nioom/laser/dokumentacja.xlsx

Sheet: Wartości
 | <- można zmieniać
Nazwa | Wartość | [ ] | Pozostałe specyfikacje | Opis
fSW | 400 | kHz |  | częstotliwość przełączania
UIN | 12 | V |  | napięcie na wejściu
UOUT | 4.6 | V |  | napięcie na diodzie
ILED | 1.8 | A |  | prąd na diodzie
RLED | 0.4 | Ω |  | rezystancja dynamiczna diody, z wykresu
UREF | 0.2 | V |  | napięcie referencyjne
ILED(ripple)max | 0.02 | A |  | max. prąd tętnienia na diodzie
KIND | 0.2 |  |  | współczynnik tętnienia (limit 20% tętnienia)
UDIM | 2.2 | V |  | napięcie max. na pinie DIM
UPANGOLIN | 5 | V |  | napięcie od pangolina
C4 / CVCC | 1 | µF | 16V | stabilizacja regulatora
R4 / RFLT | 100 | Ω |  | rezystor filtrujący
C6 / CFLT | 1 | nF | 50V X7R ceramiczny | kondensator filtrujący
R3 / RCOMP | 100 | Ω |  | rezystor kompensacyjny
C5 / CCOMP | 1 | nF | 10V X7R ceramiczny | kondensator kompensacyjny
R6 / RLK_COMP | 22 | kΩ |  | kompensacja common-mode leakage
C1 / CIN | 47 | µF | 25V/50V elektrolityczny | główna pojemność*
C2 / CIN | 22 | µF | 25V/50V X7R ceramiczny | filtr tętnienia*
C3 / CVIN | 0.1 | µF | 25V/50V X7R ceramiczny | filtr hf*
C8 | 0.1 | µF | 25V/50V X7R ceramiczny | filtr hf na wyjściu
R7, R8, R9, R10 | 10 | kΩ |  | opamp
Z obliczeń (zmieniać na drugiej stronie):
R5 / RSENSE | 0.11 | Ω | 0,5 W | rezystor ograniczający prąd na diodzie
L | 22 | µH |  | indukcyjność cewki
C7 / CCOUT | 44 | µF | 25V/50V X7R ceramiczny | kondensator wyjściowy
R1 | 22 | kΩ |  | dzielnik napięcia na pinie DIM
R2 | 15 | kΩ

Sheet: Obliczenia
Nazwa | Wzór | Wynik | Wybrana wartość | [ ] | Opis
R5 / RSENSE | #VALUE! | 0.1111111111 | 0.11 | Ω | rezystor ograniczający prąd na diodzie
 |  | 0.3564 | 0.5 | W | moc na nim wydzielana
L | #VALUE! | 1.969907407e-05 | 22 | µH | indukcyjność cewki (IL(max) = ILED)
IL(ripple) | #VALUE! | 0.32 |  | A | tętnienie prądu na cewce, powinno być < 30%ILED = 0,54A
IL(peak) | #VALUE! | 1.96 |  | A | prąd nasycenia powinien być większy niż to
IL(rms) | #VALUE! | 1.80 |  | A | prąd znamionowy większy niż to
ZCOUT | #VALUE! | 0.0265 |  | Ω | minimalna impedancja na kondensatorze wyjściowym
C7 / CCOUT | #VALUE! | 1.503802348e-05 | 44 | µF | pojemność kondensatora wyjściowego x2
ZCOUT(real) | #VALUE! | 0.009 |  | Ω | rzeczywista impedancja
ILED(ripple) | #VALUE! | 0.007 |  | A | rzeczywiste tętnienie prądu LED (powinno być < 0,02A)
kPANGOLIN | #VALUE! | 0.44 |  |  | współczynnik do dzielnika napięcia na pinie DIM
R1 | proporcja | 56 | 22 | kΩ | dzielnik napięcia
R2 | proporcja | 44 | 15 | kΩ

Sheet: Dokumentacja
Nazwa | Link
TPS922051 | https://www.ti.com/lit/ds/symlink/tps922051.pdf?ts=1765485444840
Dioda NDG7475 | https://www.laserpointeur.com/c-40_104-p-10364.html
 | https://sites.google.com/site/dtrslasershop/dtrs-shop/diodes/ndg7475-1w-520nm

Sheet: BOM
opis | wartość | jednostka | ilość | ilość min | cena za sztukę | cena | link |  | uwagi
kondensator elektrolityczny | 47 | uF | 1 | 10 | 0.621 | 6.21 | TME (https://www.tme.eu/pl/details/sc1e476m6l005vr/kondensatory-elektrolityczne-smd/samwha/)
kondensator ceramiczny X7R 25V | 22 | uF | 5 | 10 | 0.918 | 9.18 | TME (https://www.tme.eu/pl/details/cl32b226kajnnne/kondensatory-mlcc-smd/samsung/)
kondensator ceramiczny | 100 | nF | 5 | 100 | 0.146 | 14.6 | mouser (https://www.mouser.pl/ProductDetail/TAIYO-YUDEN/MCASG168SB7104KTNA1J?qs=tlsG%2FOw5FFjWcbkHvwFonQ%3D%3D)
kondensator ceramiczny | 1 | uF | 1 | 10 | 0.288 | 2.88 | TME (https://www.tme.eu/pl/details/vj0603y105kxacw1bc/kondensatory-mlcc-smd/vishay/)
kondensator ceramiczny | 1 | nF | 2 | 10 | 0.142 | 1.42 | mouser (https://www.mouser.pl/ProductDetail/Vishay-Vitramon/VJ0603Y102KXBCW1BC?qs=o80U4RH5mTFKP2GWZao9Sg%3D%3D)
rezystor | 22 | kΩ | 2 | 50 | 0.0178 | 0.89 | TME (https://www.tme.eu/pl/details/wr06x223jtl/rezystory-smd/walsin/wr06x223-jtl/)
rezystor | 100 | Ω | 3 | 50 | 0.0229 | 1.145 | TME (https://www.tme.eu/pl/details/wr06x1000ftl/rezystory-smd/walsin/)
rezystor (0.5 W) pomiarowy | 0.11 | Ω | 1 | 5 | 1.18 | 5.9 | mouser (https://www.mouser.pl/ProductDetail/Susumu/RL1632R-R110-F?qs=tWzOfa%2FtRRwDOBij%2FFJT8g%3D%3D)
rezystor | 10 | kΩ | 4 | 100 | 0.0271 | 2.71 | TME (https://www.tme.eu/pl/details/smd0603-10k/rezystory-smd/royalohm/0603saj0103t5e/)
potencjometr | 20 | kΩ | 1 | 5 | 1.369 | 6.845 | TME (https://www.tme.eu/pl/details/t910w-20k/potencjometry-tht-wieloobrotowe-3-8-cala/sr-passives/)
rezystor | 330 | Ω | 1 | 100 | 0.004 | 0.4 | TME (https://www.tme.eu/pl/details/wr06x3300ftl/rezystory-smd/walsin/)
dioda | B340A |  | 1 | 10 | 0.985 | 9.85 | mouser (https://www.mouser.pl/ProductDetail/Diodes-Incorporated/B340A-13-F?qs=aLaTXeBcTP9fj%2FYKVo6Q1A%3D%3D) | TME (https://www.tme.eu/pl/details/b340a-13-f/diody-schottky-smd/diodes-incorporated/)
cewka | 22 | uH | 1 | 3 | 2.11 | 6.33 | mouser (https://www.mouser.pl/ProductDetail/Laird-Technologies/MGAH0603220M-10?qs=By6Nw2ByBD1zgP2fZJk%252Bqw%3D%3D)
op-amp | MCP6001-OT |  | 1 | 3 | 1.11 | 3.33 | TME (https://www.tme.eu/pl/details/mcp6001t-i_ot/wzmacniacze-operacyjne-smd/microchip-technology/) | mouser (https://www.mouser.pl/ProductDetail/Microchip-Technology/MCP6001T-E-OT?qs=npqfqDPP3%2FwkX3GgGH%252BE4A%3D%3D)
stabilizator | AP2210 |  | 1 | 5 | 0.23 | 1.15 | TME (https://www.tme.eu/pl/details/ap2210k-adjtrg1/stabilizatory-napiecia-regulowane-ldo/diodes-incorporated/)
driver | TPS922051 |  | 1 | 3 | 2.66 | 7.98 | digikey (https://www.digikey.pl/pl/products/detail/texas-instruments/TPS922051D2DGNR/26700032) | mouser (https://www.mouser.pl/ProductDetail/Texas-Instruments/TPS922051D2DGNR?qs=3GbUB62Nf7cRDUq%252BgOXSvQ%3D%3D) | na razie nie dostępny na mouser
konektor power | molex KK 396 3 pin |  | 1 | 10 | 0.71 | 7.1 | TME (https://www.tme.eu/pl/details/mx-5273-03a/zlacza-sygnalowe-raster-3-96mm/molex/09-65-2038/)
konektor input | JST 2 pin |  | 1 | 10 | 0.201 | 2.01 | TME (https://www.tme.eu/pl/details/b2b-ph-k-s/zlacza-sygnalowe-raster-2-00mm/jst/b2b-ph-k-s-lf-sn/)
konektor laser | molex KK 396 2 pin |  | 1 | 10 | 0.566 | 5.66 | TME (https://www.tme.eu/pl/details/mx-5273-02a/zlacza-sygnalowe-raster-3-96mm/molex/09-65-2028/)
bezpiecznik | fast 2.5A |  | 1 | 5 | 0.41 | 2.05 | TME (https://www.tme.eu/pl/details/erbrg2r50v/bezpieczniki-smd-1206-szybkie/panasonic/) | mouser (https://www.mouser.pl/ProductDetail/Bel-Fuse/C1F-2.5?qs=Mr%252BgrRYddfrHutQcrDq%2Fcw%3D%3D)
dioda | zielona |  | 1 | 10 | 0.0339 | 0.339 | TME (https://www.tme.eu/pl/details/ltst-c190kgkt/diody-led-smd-kolorowe/liteon/)
 |  |  |  |  |  | 97.979
