nioom/laser/laser_driver/models/MGAH0603220M-10.stp

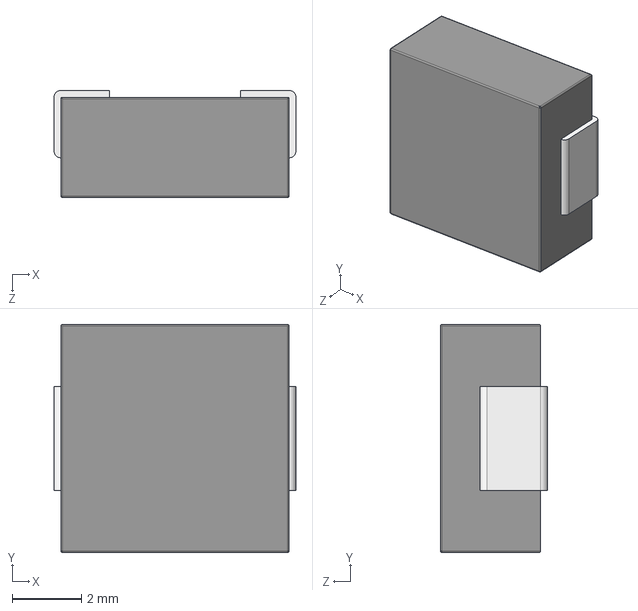
[picture p1: CAD file, 2025-12-26]
laser_driver/models/MGAH0603220M-10.stp
7.00 x 6.60 x 3.10 mm
