nioom/laser/laser_driver/laser_driver.kicad_pcb

## KiCad design laser_driver/laser_driver.kicad_pcb (2025-12-27)

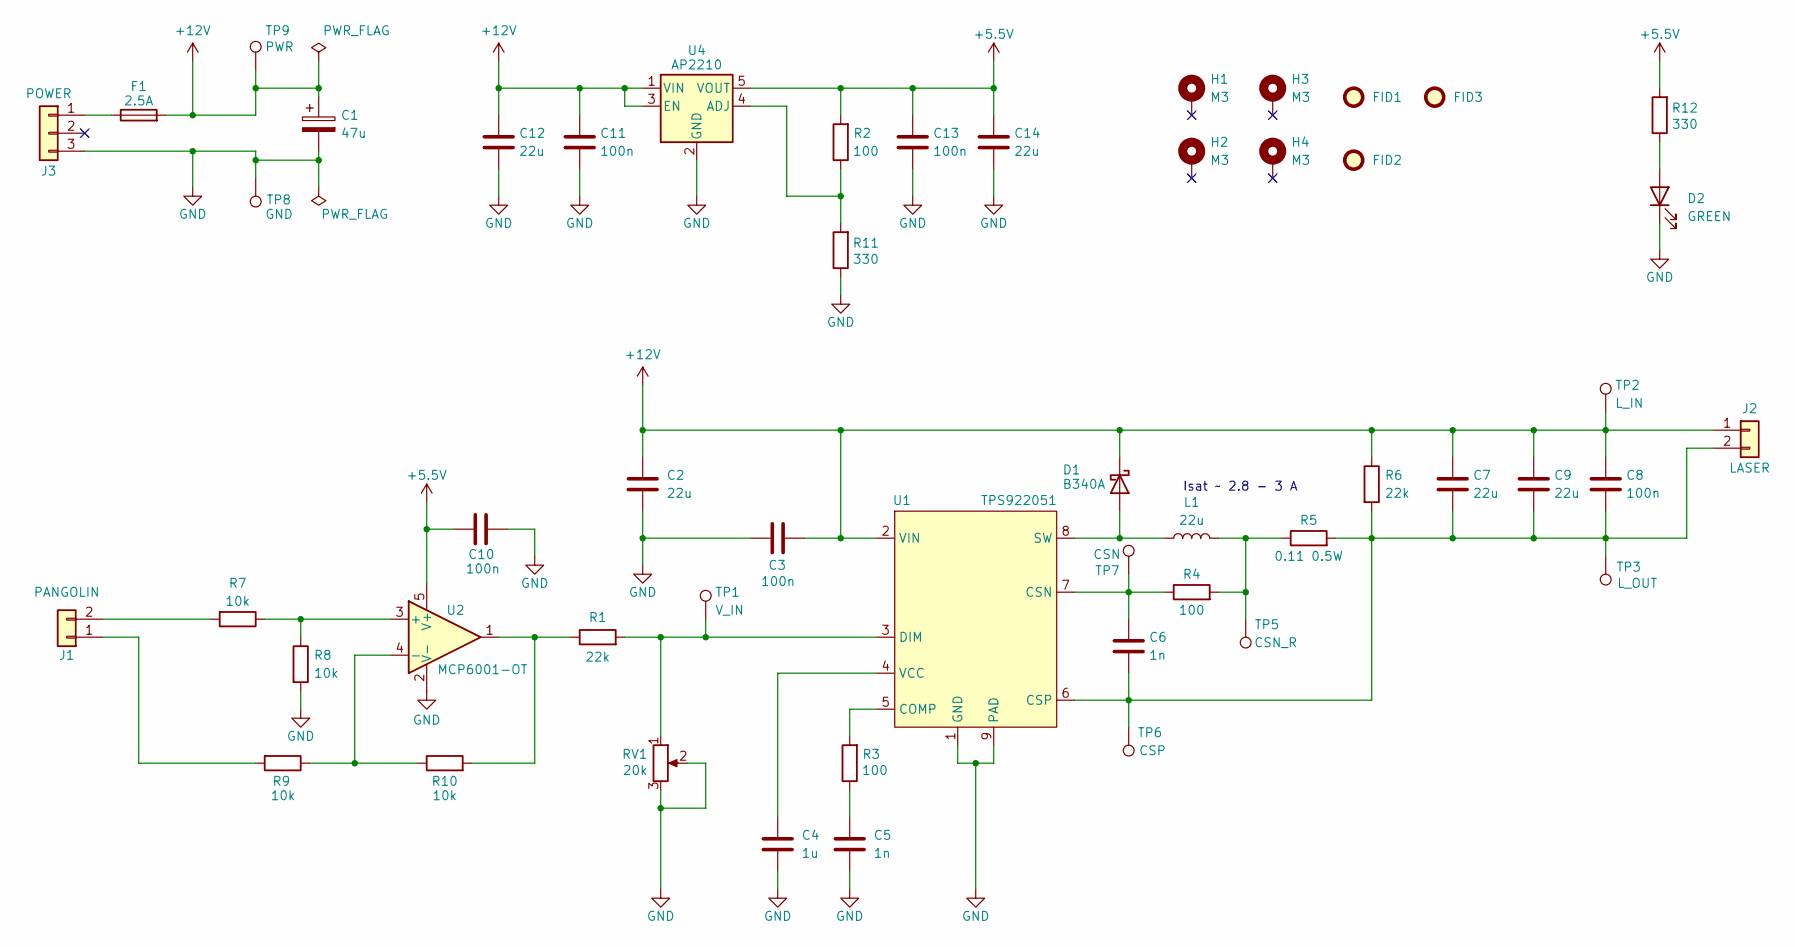
[picture p2: schematic laser_driver.kicad_sch, Driver do lasera]

Parts:
C1: 47u; CP_Elec_6.3x5.3
C2, C7, C9, C12, C14: 22u; C_1210_3225Metric_Pad1.33x2.70mm_HandSolder
C3, C8, C10, C11, C13: 100n; C_0603_1608Metric_Pad1.08x0.95mm_HandSolder
C4: 1u; C_0603_1608Metric_Pad1.08x0.95mm_HandSolder
C5, C6: 1n; C_0603_1608Metric_Pad1.08x0.95mm_HandSolder
D1: B340A; D_SMA
D2: GREEN; D_0603_1608Metric_Pad1.05x0.95mm_HandSolder
F1: 2.5A; Fuse_1206_3216Metric_Pad1.42x1.75mm_HandSolder
FID1, FID2, FID3: Fiducial_1mm_Mask2mm
H1, H2, H3, H4: M3; MountingHole_3.2mm_M3_ISO7380_Pad
J1: PANGOLIN; JST_PH_B2B-PH-K_1x02_P2.00mm_Vertical
J2: LASER; Molex_KK-396_5273-02A_1x02_P3.96mm_Vertical
J3: POWER; Molex_KK-396_5273-03A_1x03_P3.96mm_Vertical
L1: 22u; MGAH0603220M-10
R1, R6: 22k; R_0603_1608Metric_Pad0.98x0.95mm_HandSolder
R2, R3, R4: 100; R_0603_1608Metric_Pad0.98x0.95mm_HandSolder
R5: 0.11 0.5W; R_1206_3216Metric
R7, R8, R9, R10: 10k; R_0603_1608Metric_Pad0.98x0.95mm_HandSolder
R11, R12: 330; R_0603_1608Metric_Pad0.98x0.95mm_HandSolder
RV1: 20k; Potentiometer_Bourns_3296W_Vertical
TP1: V_IN; TestPoint_Pad_D1.5mm
TP2: L_IN; TestPoint_Pad_D1.5mm
TP3: L_OUT; TestPoint_Pad_D1.5mm
TP5: CSN_R; TestPoint_Pad_D1.5mm
TP6: CSP; TestPoint_Pad_D1.5mm
TP7: CSN; TestPoint_Pad_D1.5mm
TP8: GND; TestPoint_Pad_D1.5mm
TP9: PWR; TestPoint_Pad_D1.5mm
U1: TPS922051; HVSSOP-8-1EP_3x3mm_P0.65mm_EP1.57x1.89mm_ThermalVias
U2: MCP6001-OT; SOT-23-5
U4: AP2210; SOT-23-5

Connections:
+5.5V: C10.1, C13.1, C14.1, R2.2, R12.2, U2.5 (V+), U4.5 (VOUT)
+12V: C1.1, C2.1, C3.2, C7.1, C8.1, C9.1, C11.1, C12.1, D1.1 (K), F1.2, J2.1, R6.1, TP2.1, TP9.1, U1.2 (VIN), U4.1 (VIN), U4.3 (EN)
GND: C1.2, C2.2, C3.1, C4.2, C5.2, C10.2, C11.2, C12.2, C13.2, C14.2, D2.1 (K), J3.3, R8.2, R11.1, RV1.2, RV1.3, TP8.1, U1.1 (GND), U1.9 (PAD), U2.2 (V-), U4.2 (GND)
unnamed: C5.1, R3.1
unnamed: D1.2 (A), L1.1, U1.8 (SW)
unnamed: D2.2 (A), R12.1
unnamed: J1.1, R9.2
unnamed: J1.2, R7.2
unnamed: C6.2, C7.2, C8.2, C9.2, J2.2, R5.2, R6.2, TP3.1, TP6.1, U1.6 (CSP)
unnamed: F1.1, J3.1
unnamed: L1.2, R4.2, R5.1, TP5.1
unnamed: R1.1, R10.2, U2.1
unnamed: R3.2, U1.5 (COMP)
unnamed: C6.1, R4.1, TP7.1, U1.7 (CSN)
unnamed: R1.2, RV1.1, TP1.1, U1.3 (DIM)
unnamed: C4.1, U1.4 (VCC)
unnamed: R7.1, R8.1, U2.3 (+)
unnamed: R9.1, R10.1, U2.4 (-)
unnamed: R2.1, R11.2, U4.4 (ADJ)

Notes on the sheet:
Isat ~ 2.8 - 3 A

Board: 2 copper layers, 52 parts (0 on the bottom side), 19 nets, no tracks yet.
