nioom/laser/(commit log)

2025-12-21 Poprawiony schemat oraz wartości komponentów
    [dokumentacja.xlsx, laser_driver.kicad_sch]
2025-12-25 Poprawki do schematu oraz dobór footprintów i BOM
    [dokumentacja.xlsx, laser_driver.kicad_pcb, laser_driver.kicad_sch]
2025-12-26 Ostatnie poprawki do schematu
    [MGAH0603220M-10.stp, dokumentacja.xlsx, laser_driver.kicad_sch]
2025-12-27 Teraz już na pewno statnie poprawki do schematu
    [dokumentacja.xlsx, laser_driver.kicad_pcb, laser_driver.kicad_sch]
